king-obvious-iii/FSL_UR/mainboard.kicad_pcb

## KiCad design mainboard.kicad_pcb (2026-01-31)

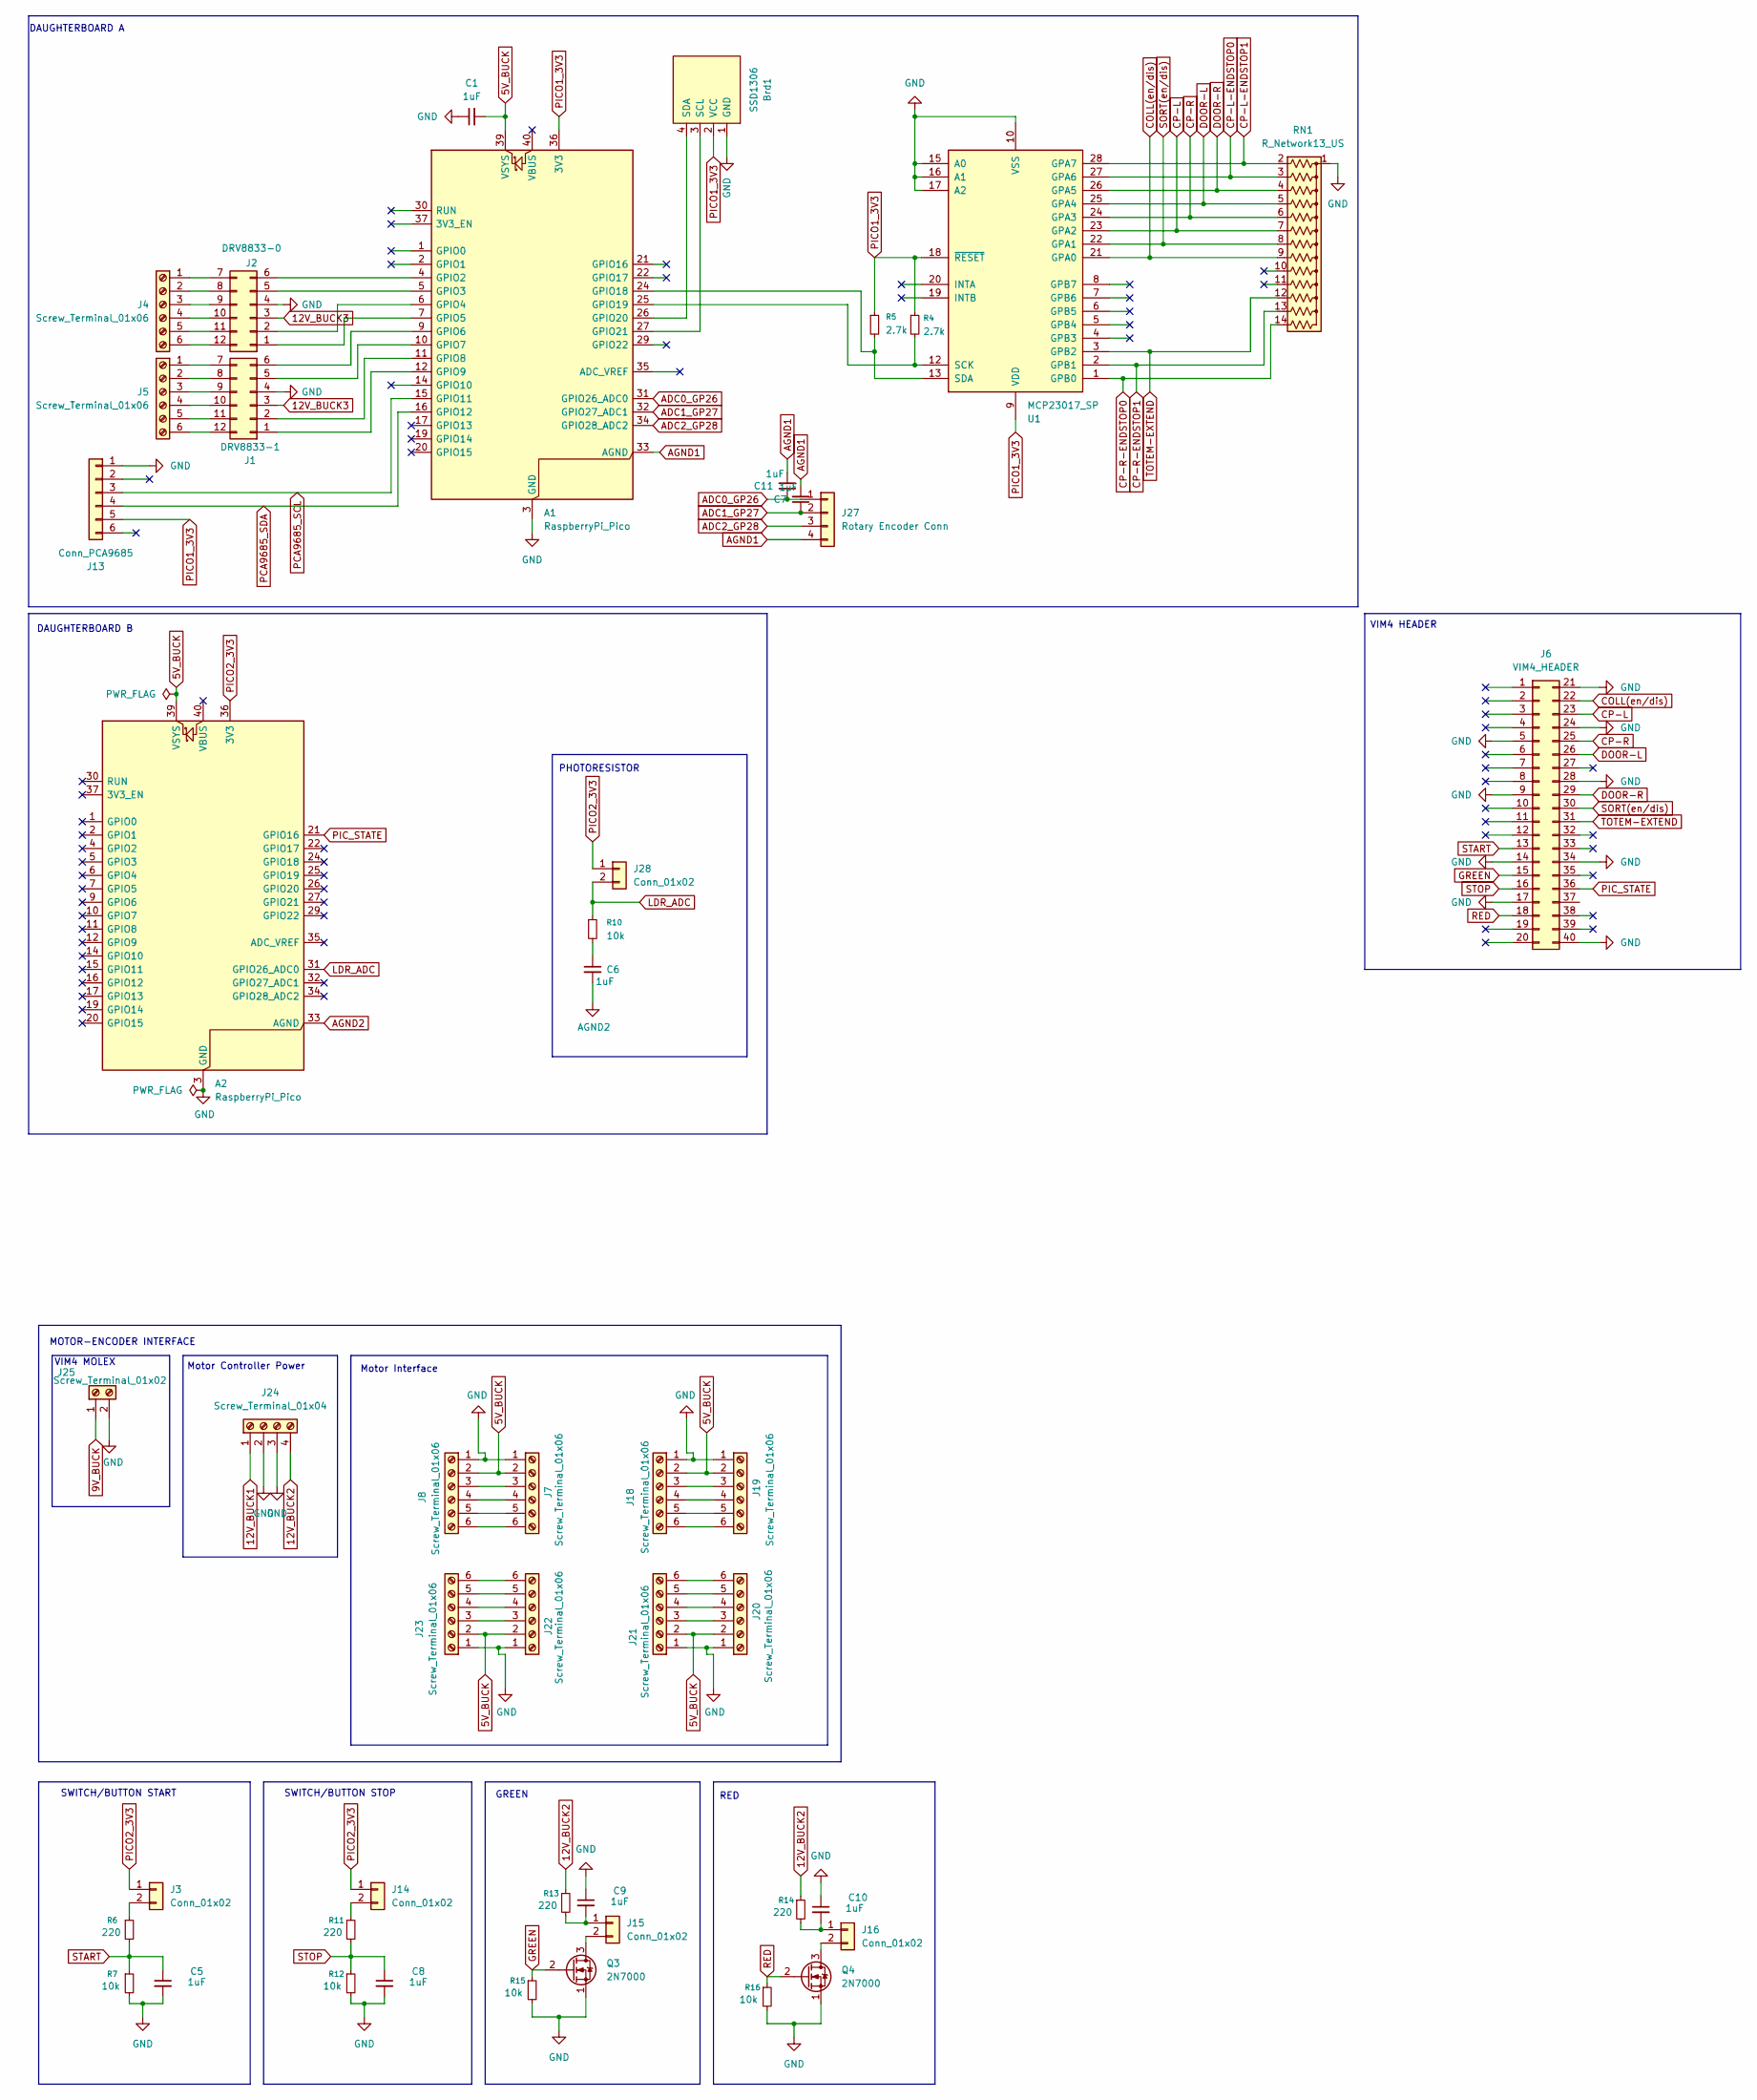
[picture p1: schematic mainboard.kicad_sch]

Parts:
A1, A2: RaspberryPi_Pico; RaspberryPi_Pico_Common_Unspecified
Brd1: SSD1306; Molex_KK-254_AE-6410-04A_1x04_P2.54mm_Vertical
C1, C5, C6, C7, C8, C9, C10, C11: 1uF; C_0805_2012Metric
J1: DRV8833-1; DRV8833
J2: DRV8833-0; DRV8833
J3, J14, J15, J16: Conn_01x02; PinHeader_1x02_P2.54mm_Vertical
J4, J5, J7, J8, J18, J19, J20, J21, J22, J23: Screw_Terminal_01x06; TerminalBlock_Xinya_XY308-2.54-6P_1x06_P2.54mm_Horizontal
J6: VIM4_HEADER; IDC-Header_2x20_P2.54mm_Vertical
J13: Conn_PCA9685; JST_EH_B6B-EH-A_1x06_P2.50mm_Vertical
J24: Screw_Terminal_01x04; PinHeader_1x04_P2.54mm_Vertical
J25: Screw_Terminal_01x02; PinHeader_1x02_P2.54mm_Vertical
J27: Rotary Encoder Conn; JST_EH_B4B-EH-A_1x04_P2.50mm_Vertical
J28: Conn_01x02; JST_EH_B2B-EH-A_1x02_P2.50mm_Vertical
Q3, Q4: 2N7000; TO-92_Inline
R4, R5: 2.7k; R_0805_2012Metric
R6, R11, R13, R14: 220; R_0805_2012Metric
R7, R10, R12, R15, R16: 10k; R_0805_2012Metric
RN1: R_Network13_US; DIP-14_W7.62mm
U1: MCP23017_SP; DIP-28_W7.62mm

Connections:
5V_BUCK: A1.39 (VSYS), A2.39 (VSYS), C1.2, J7.2, J8.2, J18.2, J19.2, J20.2, J21.2, J22.2, J23.2; also elsewhere on the board
5V_BUCK2: J13.6
9V_BUCK: J25.1; also elsewhere on the board
12V_BUCK1: J24.1
12V_BUCK2: J24.4, R13.1, R14.1
12V_BUCK3: J1.3, J2.3
ADC0_GP26: A1.31 (GPIO26_ADC0), C11.1, J27.1
ADC1_GP27: A1.32 (GPIO27_ADC1), C7.1, J27.2
ADC2_GP28: A1.34 (GPIO28_ADC2), J27.3
AGND1: A1.33 (AGND), C7.2, C11.2, J27.4
AGND2: A2.33 (AGND), C6.2
COLL(en/dis): J6.22, RN1.9 (R8), U1.21 (GPA0)
CP-L: J6.23, RN1.7 (R6), U1.23 (GPA2)
CP-L-ENDSTOP0: RN1.3 (R2), U1.27 (GPA6); also elsewhere on the board
CP-L-ENDSTOP1: RN1.2 (R1), U1.28 (GPA7); also elsewhere on the board
CP-R: J6.25, RN1.6 (R5), U1.24 (GPA3)
CP-R-ENDSTOP0: RN1.14 (R13), U1.1 (GPB0); also elsewhere on the board
CP-R-ENDSTOP1: RN1.13 (R12), U1.2 (GPB1); also elsewhere on the board
DOOR-L: J6.26, RN1.5 (R4), U1.25 (GPA4)
DOOR-R: J6.29, RN1.4 (R3), U1.26 (GPA5)
GND: A1.3 (GND), A1.8 (GND), A1.13 (GND), A1.18 (GND), A1.23 (GND), A1.28 (GND), A1.38 (GND), A2.3 (GND), A2.8 (GND), A2.13 (GND), A2.18 (GND), A2.23 (GND), A2.28 (GND), A2.38 (GND), Brd1.1 (GND), C1.1, C5.2, C8.2, C9.1, C10.1, J1.4, J2.4, J6.5, J6.9, J6.14, J6.17, J6.21, J6.24, J6.28, J6.34, J6.40, J7.1, J8.1, J13.1, J18.1, J19.1, J20.1, J21.1, J22.1, J23.1, J24.2, J24.3, J25.2, Q3.1 (S), Q4.1 (S), R7.2, R12.2, R15.2, R16.2, RN1.1 (common), U1.10 (VSS), U1.15 (A0), U1.16 (A1), U1.17 (A2); also elsewhere on the board
GREEN: J6.15, Q3.2 (G), R15.1
LDR_ADC: A2.31 (GPIO26_ADC0), J28.2, R10.1
unnamed: A1.4 (GPIO2), J2.6
unnamed: A1.5 (GPIO3), J2.5
unnamed: A1.6 (GPIO4), J2.2
unnamed: A1.7 (GPIO5), J2.1
unnamed: A1.9 (GPIO6), J1.6
unnamed: A1.10 (GPIO7), J1.5
unnamed: A1.11 (GPIO8), J1.2
unnamed: A1.12 (GPIO9), J1.1
unnamed: A1.24 (GPIO18), R5.2, U1.13 (SDA)
unnamed: A1.25 (GPIO19), R4.2, U1.12 (SCK)
unnamed: A1.26 (GPIO20), Brd1.4 (SDA)
unnamed: A1.27 (GPIO21), Brd1.3 (SCL)
unnamed: C6.1, R10.2
unnamed: J1.7, J5.1
unnamed: J1.8, J5.2
unnamed: J1.9, J5.3
unnamed: J1.10, J5.4
unnamed: J1.11, J5.5
unnamed: J1.12, J5.6
unnamed: J2.7, J4.1
unnamed: J2.8, J4.2
unnamed: J2.9, J4.3
unnamed: J2.10, J4.4
unnamed: J2.11, J4.5
unnamed: J2.12, J4.6
unnamed: J3.2, R6.1
unnamed: J7.3, J8.3
unnamed: J7.4, J8.4
unnamed: J7.5, J8.5
unnamed: J7.6, J8.6
unnamed: J14.2, R11.1
unnamed: C9.2, J15.1, R13.2
unnamed: J15.2, Q3.3 (D)
unnamed: C10.2, J16.1, R14.2
unnamed: J16.2, Q4.3 (D)
unnamed: J18.3, J19.3
unnamed: J18.4, J19.4
unnamed: J18.5, J19.5
unnamed: J18.6, J19.6
unnamed: J20.3, J21.3
unnamed: J20.4, J21.4
unnamed: J20.5, J21.5
unnamed: J20.6, J21.6
unnamed: J22.3, J23.3
unnamed: J22.4, J23.4
unnamed: J22.5, J23.5
unnamed: J22.6, J23.6
PCA9685_SCL: A1.15 (GPIO11), J13.3
PCA9685_SDA: A1.16 (GPIO12), J13.4
PIC_STATE: A2.21 (GPIO16), J6.36
RED: J6.18, Q4.2 (G), R16.1
SORT(en/dis): J6.30, RN1.8 (R7), U1.22 (GPA1)
START: C5.1, J6.13, R6.2, R7.1
STOP: C8.1, J6.16, R11.2, R12.1
TOTEM-EXTEND: J6.31, RN1.12 (R11), U1.3 (GPB2)

Notes on the sheet:
DAUGHTERBOARD A
Motor Controller Power
VIM4 MOLEX
PHOTORESISTOR
GREEN
Motor Interface
MOTOR-ENCODER INTERFACE
VIM4 HEADER
RED
DAUGHTERBOARD B
SWITCH/BUTTON STOP
SWITCH/BUTTON START

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
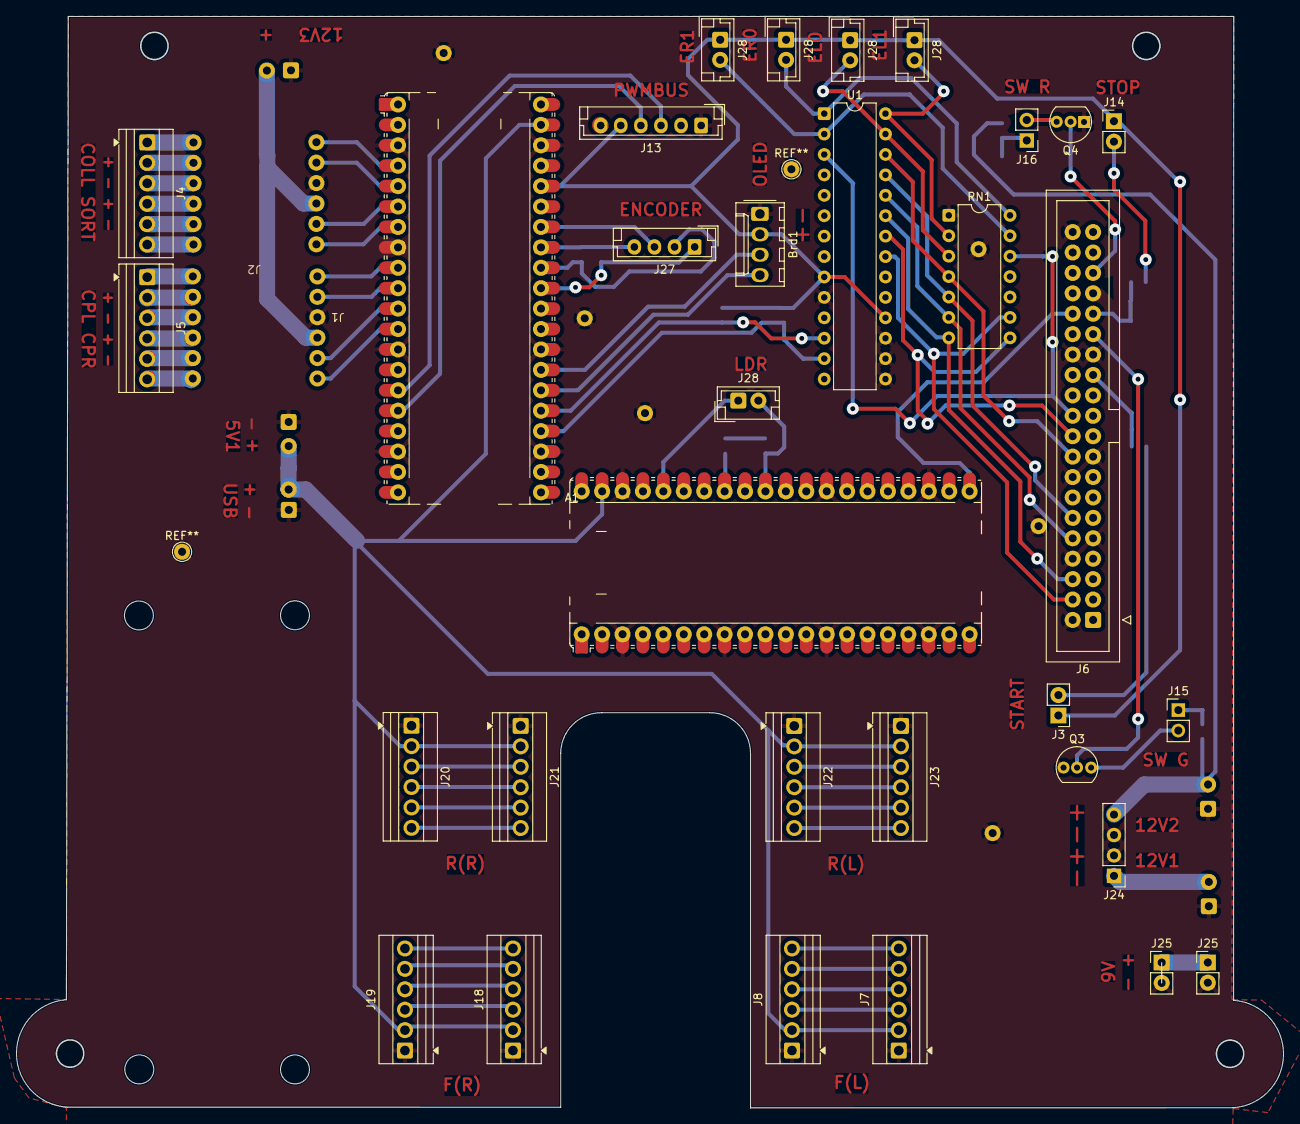
[picture p2: board mainboard.kicad_pcb from above]

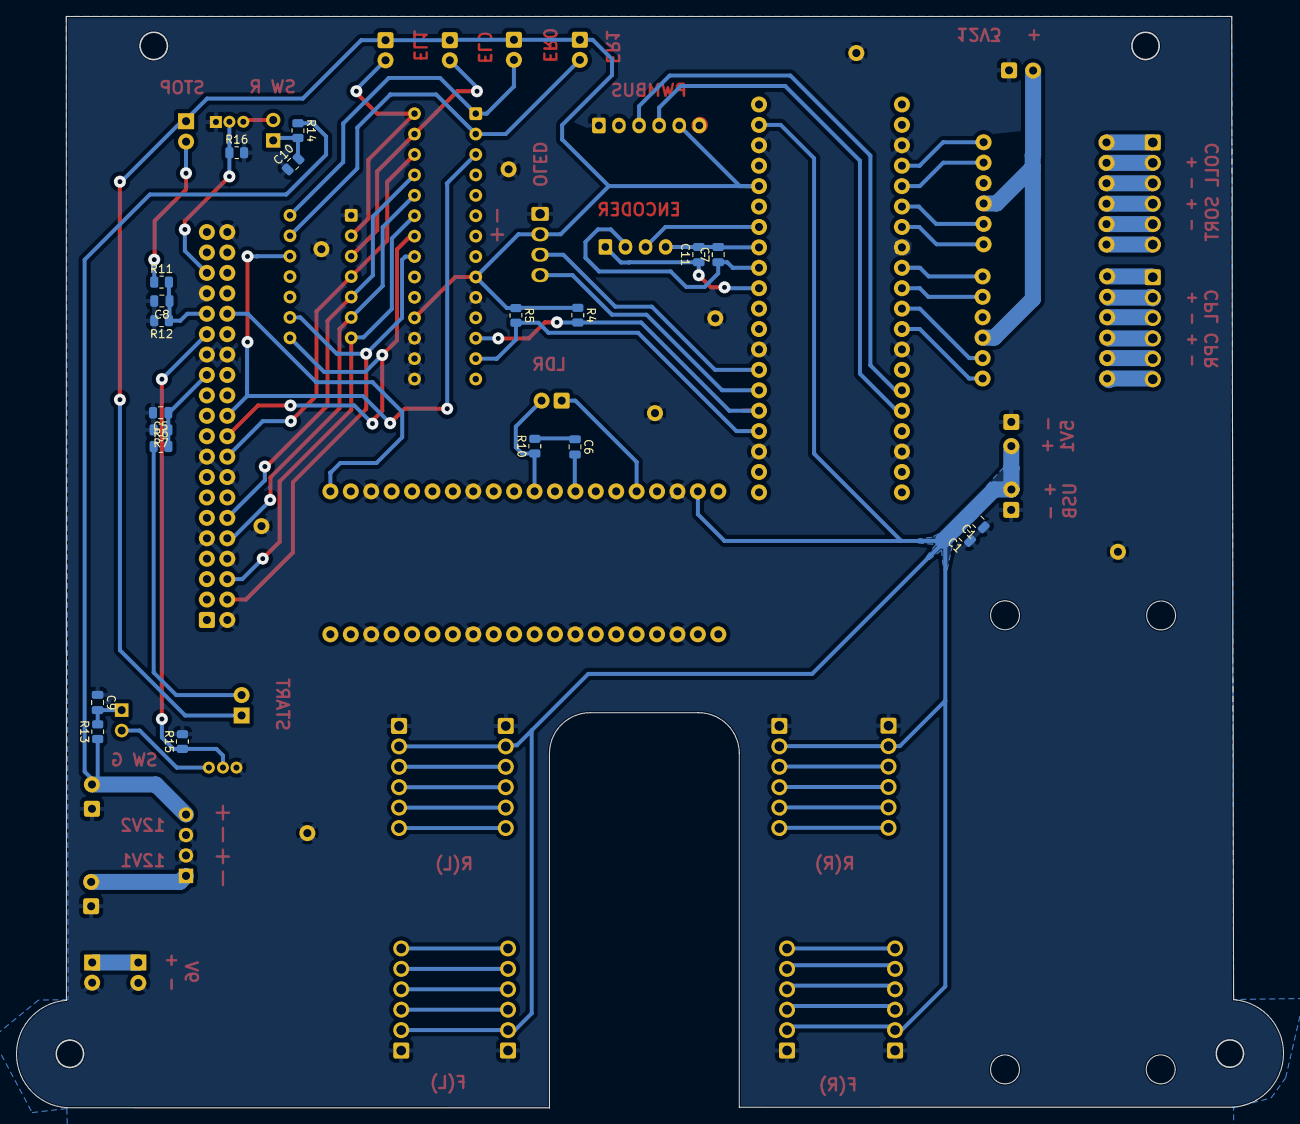
[picture p3: board mainboard.kicad_pcb from below]

Board: 2 copper layers, 157.6 x 135.8 mm, 54 parts (20 on the bottom side), 78 nets.

Other parts of the board:
C1#2: 1uF; C_0805_2012Metric
J25#2: Screw_Terminal_01x02; PinHeader_1x02_P2.54mm_Vertical
J28#2, J28#3, J28#4, J28#5: Conn_01x02; JST_EH_B2B-EH-A_1x02_P2.50mm_Vertical

Their connections:
5V_BUCK: C1#2.2; also elsewhere on the board
9V_BUCK: J25#2.1; also elsewhere on the board
CP-L-ENDSTOP0: J28#2.2; also elsewhere on the board
CP-L-ENDSTOP1: J28#3.2; also elsewhere on the board
CP-R-ENDSTOP0: J28#5.2; also elsewhere on the board
CP-R-ENDSTOP1: J28#4.2; also elsewhere on the board
GND: C1#2.1, J25#2.2; also elsewhere on the board
