king-obvious-iii/FSL_UR/(commit log)

2025-12-13 Mainboard schematics
    [mainboard.kicad_sch]
2025-12-15 Added LDR circuit
    [mainboard.kicad_sch]
2025-12-15 Bucks added
    Bucks added, nets modified to match these buck names
    [mainboard.kicad_sch]
2025-12-15 Added PCB
    Added PCB and DRV8833 footprint.
    Error checked circuit for footprints to PCB
    [mainboard.kicad_pcb, mainboard.kicad_sch]
2025-12-15 General reorganization
    [mainboard.kicad_pcb]
2025-12-16 Settings import
    Imported settings for traces and routing,
    Placing and organizing PCB components into modules
    [mainboard.kicad_pcb, mainboard.kicad_sch]
2025-12-16 Circuit adjustments / PCB component Grouping
    Removed resistor on LDR in schem. Changed to 10k resistor. Added hole distance for PCA9685, SSD1309. Grouped components. Awaiting PIC_FOR_ADC from Dustin
    [mainboard.kicad_pcb, mainboard.kicad_sch]
2025-12-27 PIC16F819-ISO Added
    Added PIC, changed footprint to match our 18pin SMD.
    LDR circuit and connection to VIM4 need to be made
    [mainboard.kicad_pcb, mainboard.kicad_sch]
2025-12-29 Rearrangement and first pour
    Modified the order of operations for terminal block to fuse to buck. Added a few things like the holes for the Roboclaws, removed the display, since we're going to wire it using a JST connector in order for it to exist somewhere else on the robot. I added a PIC footprint that fits the PIC16F819-ISO, and generally hooked it up.
    I still need to check with Dustin and make sure that the VIM4 connection to the PIC is the one we want to use.
    I also need to know the exact dimensions of the PCB constraint we are designing this for.
    [mainboard.kicad_pcb, mainboard.kicad_sch]
2025-12-30 Peripheral footprint blanks and boundaries
    Peripheral footprint blanks and boundaries added
    [mainboard.kicad_pcb, mainboard.kicad_sch]
2026-01-02 Switches updated
    Enumerated all switches in the VIM header and added their respective sub-circuitry. Fixed a few errors I was getting when I updated PCB from schematic.
    [mainboard.kicad_pcb, mainboard.kicad_sch]
2026-01-02 Fixed ERC complaints
    Fixed the power and NC complaints issues when I tried to run the ERC check
    [mainboard.kicad_sch]
2026-01-09 The Great Simplification
    Schematic:
    Pico2 added, 12V buck added, Motor-Encoder Interface Added, PIC removed.
    *No work yet on PCB, will chip away at orienting objects tomorrow.
    [mainboard.kicad_pcb, mainboard.kicad_sch]
2026-01-10 First full buildup for the PCB
    Board1, bucks removed. Motor interface added,
    [buckboard.kicad_pcb, buckboard.kicad_sch, mainboard.kicad_pcb, mainboard.kicad_sch]
2026-01-10 Buckboard initial
    Dimensioned bucks.
    Placed DCF of cornpush nonmag bin face where bucks will live.
    [buckboard.kicad_pcb]
2026-01-11 0 Error DRC mainboard V1
    completed digital rules check and electrical rules check. ready to export to gerber
    [mainboard.kicad_pcb, mainboard.kicad_sch]
2026-01-12 0 Error DRC mainboard V1.1
    Little edits
    [mainboard.kicad_pcb]
2026-01-12 0 Error DRC mainboard V1.15
    Placed motor interface within boundaries, rounded off edge.cuts with some arcs.
    resized all of the pads to 2mm
    got rid of some islands and their associated vias.
    ***This version has the chassis DXF in the PCB editor.
    [mainboard.kicad_pcb]
2026-01-15 Validated mainboard V1.15
    0 Error 0 Warnings
    Ready for Ochoa chack
    [mainboard.kicad_pcb, mainboard.kicad_sch]
2026-01-17 Buckboard Beta 1
    Ready for Ochoa review
    [buckboard.kicad_pcb, mainboard.kicad_pcb, mainboard.kicad_sch]
2026-01-17 Displayboard added
    V1 of displayboard, this includes the SSD1309 and EC11 Rotary encoder with 1x04 JST connectors at 2.5mm pitch
    [buckboard.kicad_pcb, displayboard.kicad_pcb, displayboard.kicad_sch, mainboard.kicad_pcb]
2026-01-31 Ready boards
    powerboard, displayboard and mainboard all ready to mill
    [displayboard.kicad_pcb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]
